jaoRamalho/Drone/Hardware/Drone-HW.kicad_pcb

## KiCad design Hardware/Drone-HW.kicad_pcb (2025-10-14)

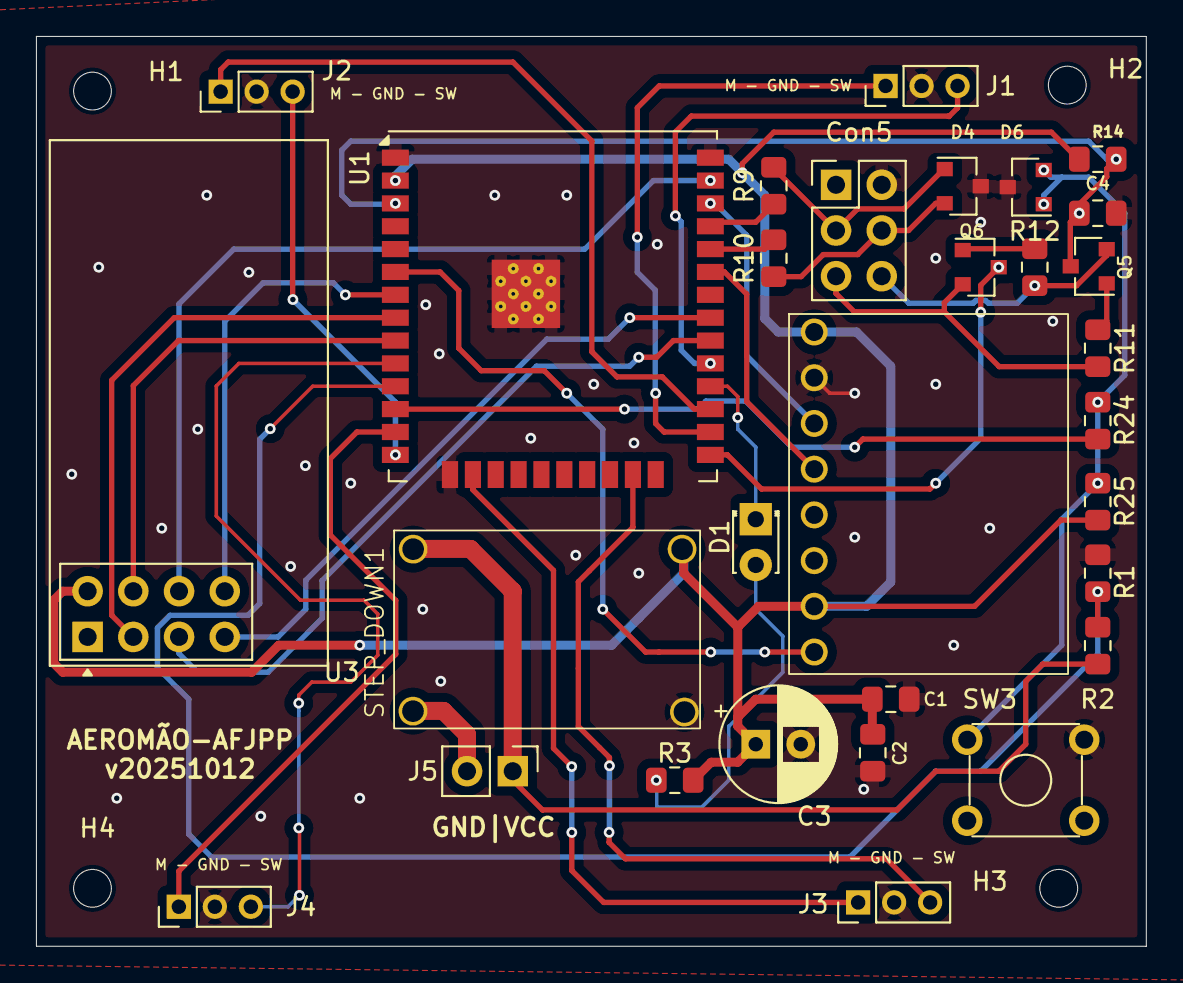
[picture p1: board Drone-HW.kicad_pcb from above]

Board: 2 copper layers, 61.7 x 50.5 mm, 34 parts (0 on the bottom side), 36 nets.

Parts:
C1, C2: 10uF/25V; C_0805_2012Metric_Pad1.15x1.40mm_HandSolder
C3: 220uF/16V; CP_Radial_D6.3mm_P2.50mm
C4: 100nF/50V; C_0805_2012Metric_Pad1.15x1.40mm_HandSolder
Con5: espTool_conn; PinHeader_2x03_P2.54mm_Vertical
D1: LED; LED_D1.8mm_W3.3mm_H2.4mm
D4, D6: TVS 3,3V; SOT-23
H1, H2, H3, H4: MountingHole; MountingHole_2.1mm
J1, J2, J3, J4: Conn_01x03; PinHeader_1x03_P2.00mm_Vertical
J5: Conn_01x02_Pin; PinHeader_1x02_P2.54mm_Vertical
Q5, Q6: BC846; SOT-23
R1, R14, R25: 10k; R_0805_2012Metric_Pad1.15x1.40mm_HandSolder
R2: 15k; R_0805_2012Metric_Pad1.15x1.40mm_HandSolder
R3: 470R; R_0805_2012Metric_Pad1.15x1.40mm_HandSolder
R9, R10, R24: 49,9R; R_0805_2012Metric_Pad1.15x1.40mm_HandSolder
R11, R12: 4,7k; R_0805_2012Metric_Pad1.15x1.40mm_HandSolder
STEP_DOWN1: STEPDOWN_23V_3V3; StepDown3v3_Module
SW3: Tactile; SW_TH_Tactile_Omron_B3F-10xx
U1: ESP32-WROOM-32D; ESP32-WROOM-32U
U2: U2; MPU6050_Module
U3: NRF24L01_Breakout; nRF24L01_Breakout

Connections:
+3V3: C1.1, C2.1, C3.1, R3.1, R14.1, R25.1, STEP_DOWN1.3 (+OUT), U1.2 (VDD), U2.1 (VCC), U2.7 (ADO), U3.2 (VCC)
+7V4: J5.1, R2.1, STEP_DOWN1.1 (+IN)
/B_START: R24.1, U1.12 (IO27)
/CE: U1.8 (IO32), U3.3 (CE)
/DTR_ESP: Con5.5 (DTR), Q6.2 (E), R11.2
/EN_ESP: C4.1, Q5.3 (C), R14.2, U1.3 (EN)
/INT: U1.6 (IO34_(IN)), U2.8 (INT)
/IO0_ESP: Q6.3 (C), U1.25 (IO0(SPU))
/IRQ: U1.7 (IO35_(IN)), U3.8 (IRQ)
/MISO: U1.31 (IO19), U3.7 (MISO)
/MOSI: U1.37 (IO23), U3.6 (MOSI)
/Motor1: J1.1, U1.26 (IO4)
/Motor2: J2.1, U1.27 (IO16)
/Motor3: J3.1, U1.16 (IO13)
/Motor4: J4.1, U1.13 (IO14)
/RTS_ESP: Con5.6 (RTS), Q5.2 (E), R12.2
/RX_USB: R10.2, U1.34 (RXD0/IO3)
/SCK: U1.30 (IO18), U3.5 (SCK)
/SCL-SPU: U1.36 (IO22), U2.3 (SCL)
/SDA-SPU: U1.33 (IO21), U2.4 (SDA)
/TX_USB: R9.1, U1.35 (TXD0/IO1)
/V_Bat: R1.1, R2.2, U1.11 (IO26)
/sw1: J1.3, U1.29 (IO5(SPU))
/sw2: J2.3, U1.14 (IO12(SPD))
/sw3: J3.3, U1.23 (IO15(SPU))
/sw4: J4.3, U1.10 (IO25)
/~CSN: U1.9 (IO33), U3.4 (~CSN)
GND: C1.2, C2.2, C3.2, C4.2, Con5.2 (GND), D4.3 (A1), D6.3 (A1), J1.2, J2.2, J3.2, J4.2, R1.2, STEP_DOWN1.4 (-OUT), SW3.2, U1.1 (GND), U1.15 (GND), U1.38 (GND), U1.39 (PAD), U2.2 (GND), U3.1 (GND)
GND_7V4: J5.2, STEP_DOWN1.2 (-IN)
unnamed: Con5.4 (RX), D4.2 (A2), R10.1
unnamed: Con5.3 (TX), D4.1 (common), R9.2
unnamed: D1.2 (A), R3.2
unnamed: D1.1 (K), U1.28 (IO17)
unnamed: D6.1 (common), D6.2 (A2), R24.2, R25.2, SW3.1
unnamed: Q5.1 (B), R11.1
unnamed: Q6.1 (B), R12.1
