jaoRamalho/Drone/(commit log)

2025-08-17 Hardware iniciado, modulo MPU6050, controle motores, ESP e gravacçao prontos
    [Drone-HW.kicad_pcb, Drone-HW.kicad_sch]
2025-08-17 Adicionando projeto de firmware
2025-08-26 Adicionando sybols e footprint dos escs e symbol do stepdown
    [Drone-HW.kicad_sch]
2025-09-04 hardware arrumado, retirando escs da pcb e diminuindo tamanho
    [Drone-HW.kicad_pcb, Drone-HW.kicad_sch]
2025-09-06 Retirando modulos escs da pcb
    [Drone-HW.kicad_pcb, Drone-HW.kicad_sch]
2025-09-06 Iniciando firmware, configuracao do pwm e Gyroscopios feitas, falta os testes
2025-09-10 Arruamndo classe de gyroscopio e adicionando arquivos de interrupcoes
2025-09-12 Finalizando hardware aguardando revisão
    [Drone-HW.kicad_pcb, Drone-HW.kicad_sch]
2025-09-16 Adicionando arquitetura de controle
2025-09-20 Transformando pwm para interrupção padrão
2025-09-21 Implementação completa da comunicação RF24 como singleton
    - Adicionada classe Communication como singleton para RF24
    - Implementada comunicação bidirecional com ACK payload
    - Configurado VS Code para desenvolvimento ESP32/PlatformIO
    - Atualizados GPIOs para nova configuração
    - Adicionadas configurações de timer para pings automáticos
    Funcionalidades:
    - Envio/recebimento de comandos via nRF24L01
    - Telemetria automática via ACK
    - Sistema de ping para manter conexão
    - Padrão singleton para acesso global à comunicação
2025-10-01 Arrumando hardware
    [Drone-HW.kicad_pcb, Drone-HW.kicad_sch]
2025-10-01 Arrumando erros de DRC hw
    [Drone-HW.kicad_pcb]
2025-10-02 alteracoes finais
    [Drone-HW-B_Cu.gbr, Drone-HW-B_Mask.gbr, Drone-HW-B_Silkscreen.gbr, Drone-HW-Edge_Cuts.gbr, Drone-HW-F_Cu.gbr, Drone-HW-F_Mask.gbr, Drone-HW-F_Silkscreen.gbr, Drone-HW-NPTH.drl]
2025-10-05 State para ativação do motor funcionando, falta criar discretização de aceleração
2025-10-14 Adicionando arquivos de timers e Melhorando maquina de estados para controle de motores
2025-10-14 Dando push na versão final de hardware
    [Drone-HW-B_Cu.gbr, Drone-HW-B_Mask.gbr, Drone-HW-B_Silkscreen.gbr, Drone-HW-Edge_Cuts.gbr, Drone-HW-F_Cu.gbr, Drone-HW-F_Mask.gbr, Drone-HW-F_Silkscreen.gbr, Drone-HW-NPTH.drl]
2025-10-14 Removendo arquivo de controle de pwm, usando lib externa
2025-10-26 Comunicação por rádio funcional com ping por interrupção e em classe Própria, interrupção agora no arquivo Timer também
2025-10-26 Comunicação por rádio funcional com protocolo simples que verifica se algum bit foi corrompido por checksum com XOR e tenta mandar o mesmo comando até 3 vezes se não foi enviado e recebido
2025-11-05 Comunicação funcionando com dois esp32 e em pastas separadas no firmware
2025-11-05 Pousos automáticos em situação de perda de conexão ou bateria baixa
2025-11-10 Incluindo led e separando melhor as funcoes do Control
2025-11-11 adicionado LABEL para os sinais
2025-11-11 Teste de hardware
2025-11-11 Alterando comentarios de logs para melhorar restreabilidade de erros
2025-11-12 Adicionando funcoes para controle dos motores
2025-11-18 Teste de latencia feito
2025-11-19 Adicionando controle por interrupcao de botao
2025-11-20 Adicionando leitura de bateria, junto com funcoes get para retorno
2025-11-24 Setagem dos setpoints para o futuro pid
2025-12-04 Correção nos Id's dos gestos, deixando somente os comandos que realmente serão utilizados
2025-12-10 Adicionando mudancas de pid
2025-12-14 Adicionando alteracoes de pid
2025-12-14 Arrumei a parte da comunicação que estava errada
2025-12-15 Adicionando alteracoes finais de integração
2025-12-16 Arrumando duplicada de controle
